ifilot/isa-sdhc-card-interface/bracket/bracket-release-card.stl

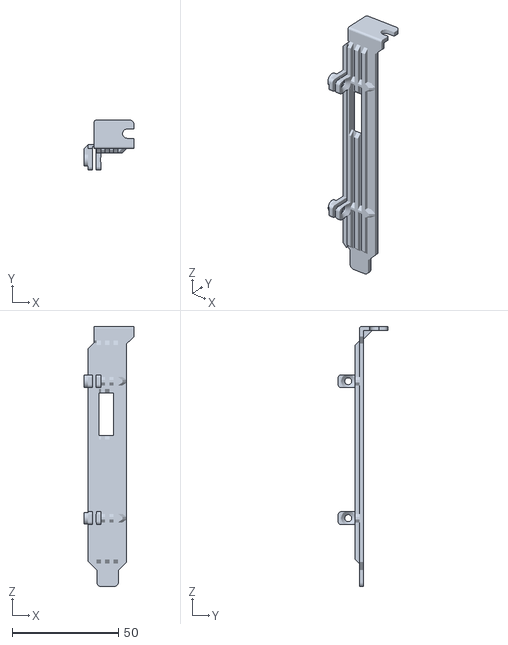
[picture p1: CAD file, 2025-10-16]
bracket/bracket-release-card.stl
23.6 x 23.5 x 122.5
