ifilot/isa-sdhc-card-interface/(list of files, cad)

Other CAD files:
bracket/bracket-prototype-card.stl
