ifilot/isa-sdhc-card-interface/pcb/prototype/prototype.pdf

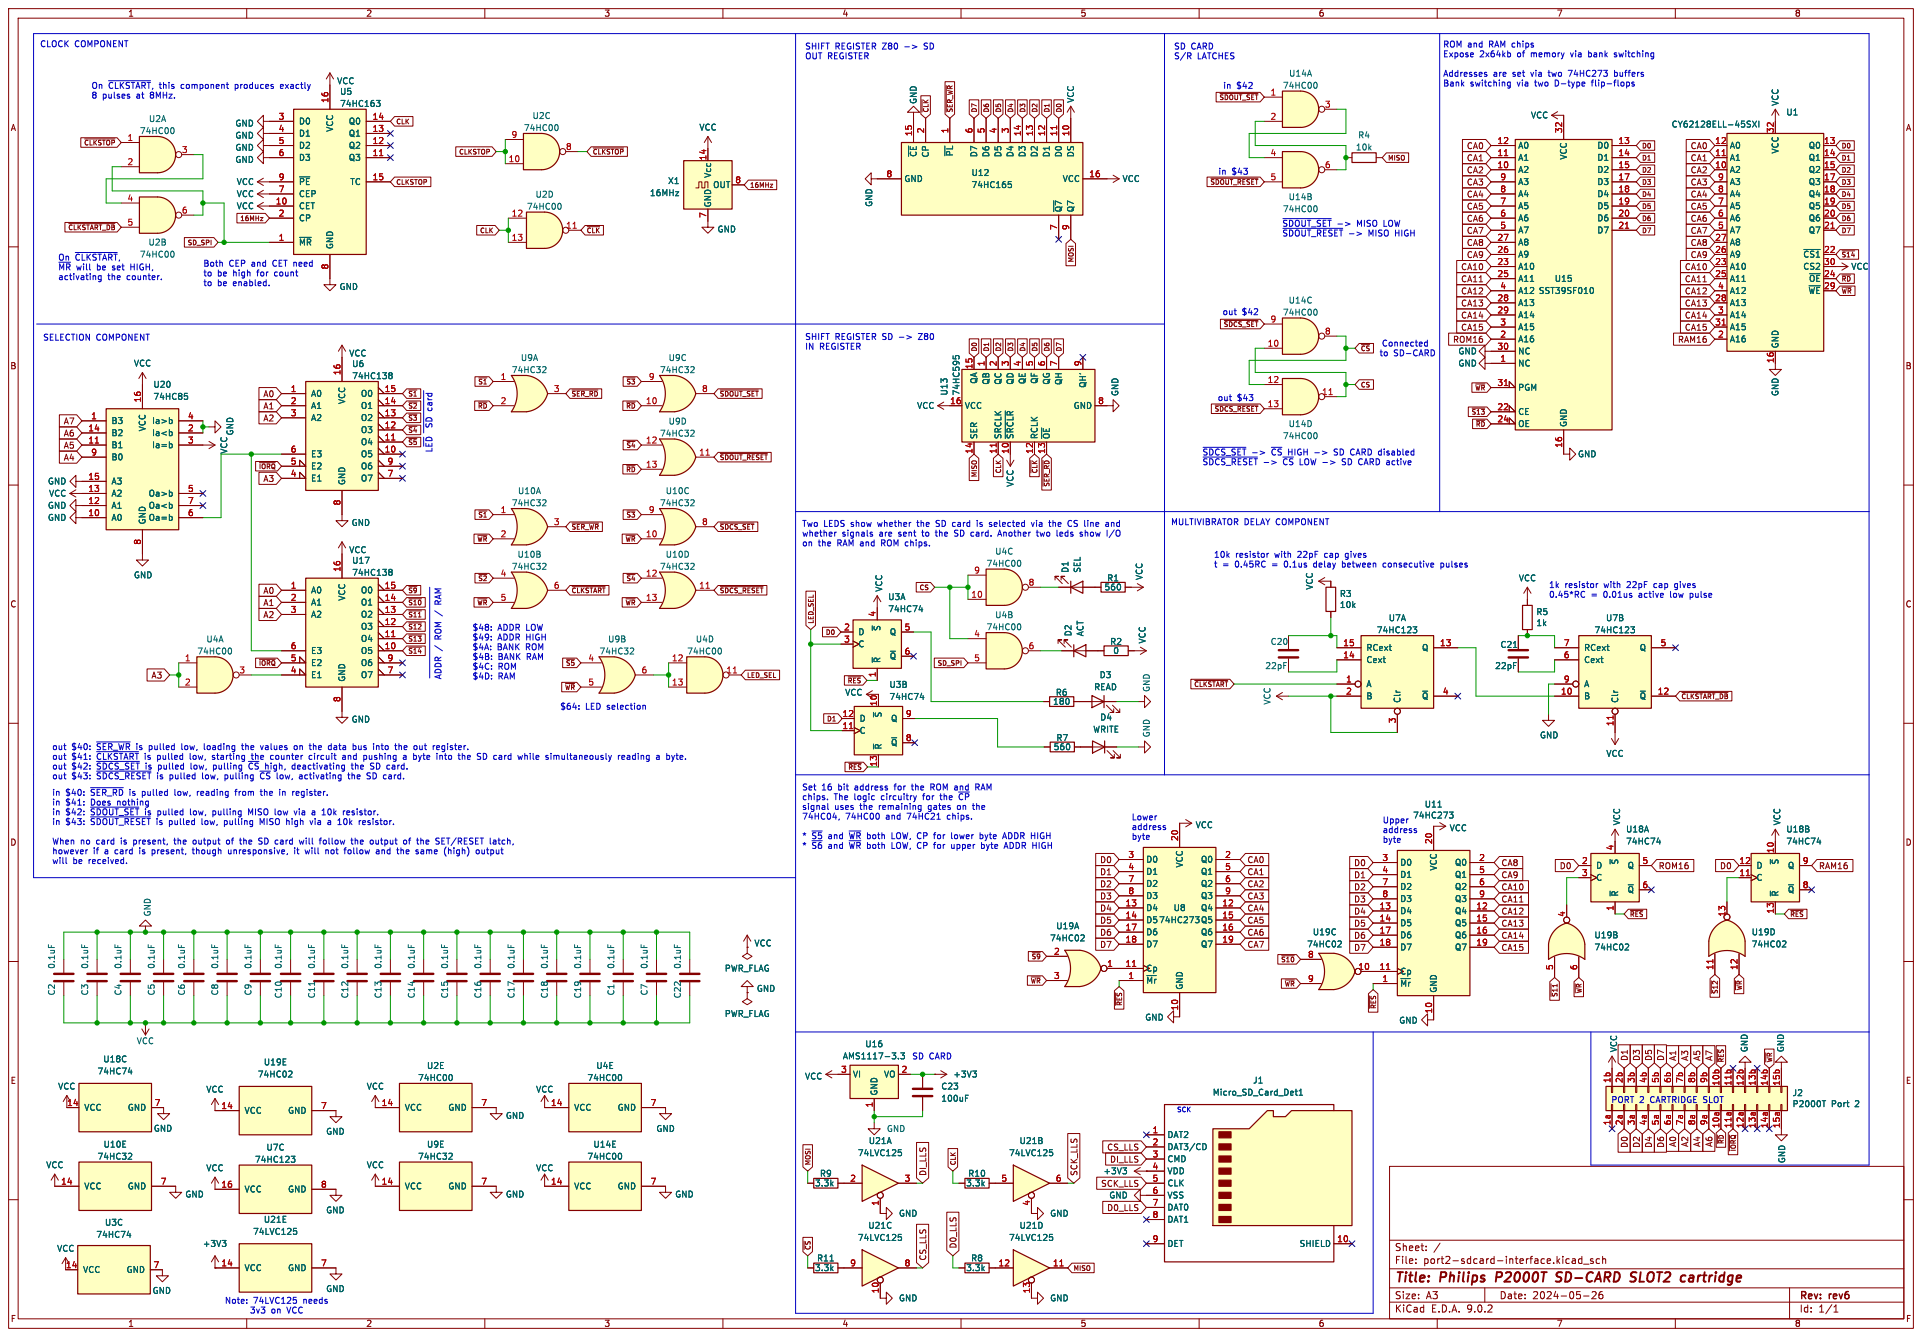
[picture p2: page 1]

8 O0 15 O1 14 O2 13 O3 12 O4 11 O5 10 O6 9 O7 7 VCC VCCGND GND GND GND GND GND

$64: LED selection On ~{CLKSTART},

Both CEP and CET need
to be high for count

MULTIVIBRATOR DELAY COMPONENT Set 16 bit address for the ROM and RAM

on the RAM and ROM chips.

in $40: ~{SER_RD}is pulled low, reading from the in register.
in $41: Does nothing

74HC04, 74HC00 and 74HC21 chips. * ~{S5}and ~{WR}both LOW, CP for lower byte ADDR HIGH

* ~{S6}and ~{WR}both LOW, CP for upper byte ADDR HIGH

Id: 1/1 Title: Philips P2000T SD-CARD SLOT2 cartridge
