ifilot/isa-sdhc-card-interface/(list of files, drawings)

Other design files:
pcb/prototype/prototype.dsn
pcb/release/isa-sdcard.dsn
