ifilot/isa-sdhc-card-interface/pcb/release/isa-sdcard.kicad_pcb

## KiCad design pcb/release/isa-sdcard.kicad_pcb (2025-10-16)

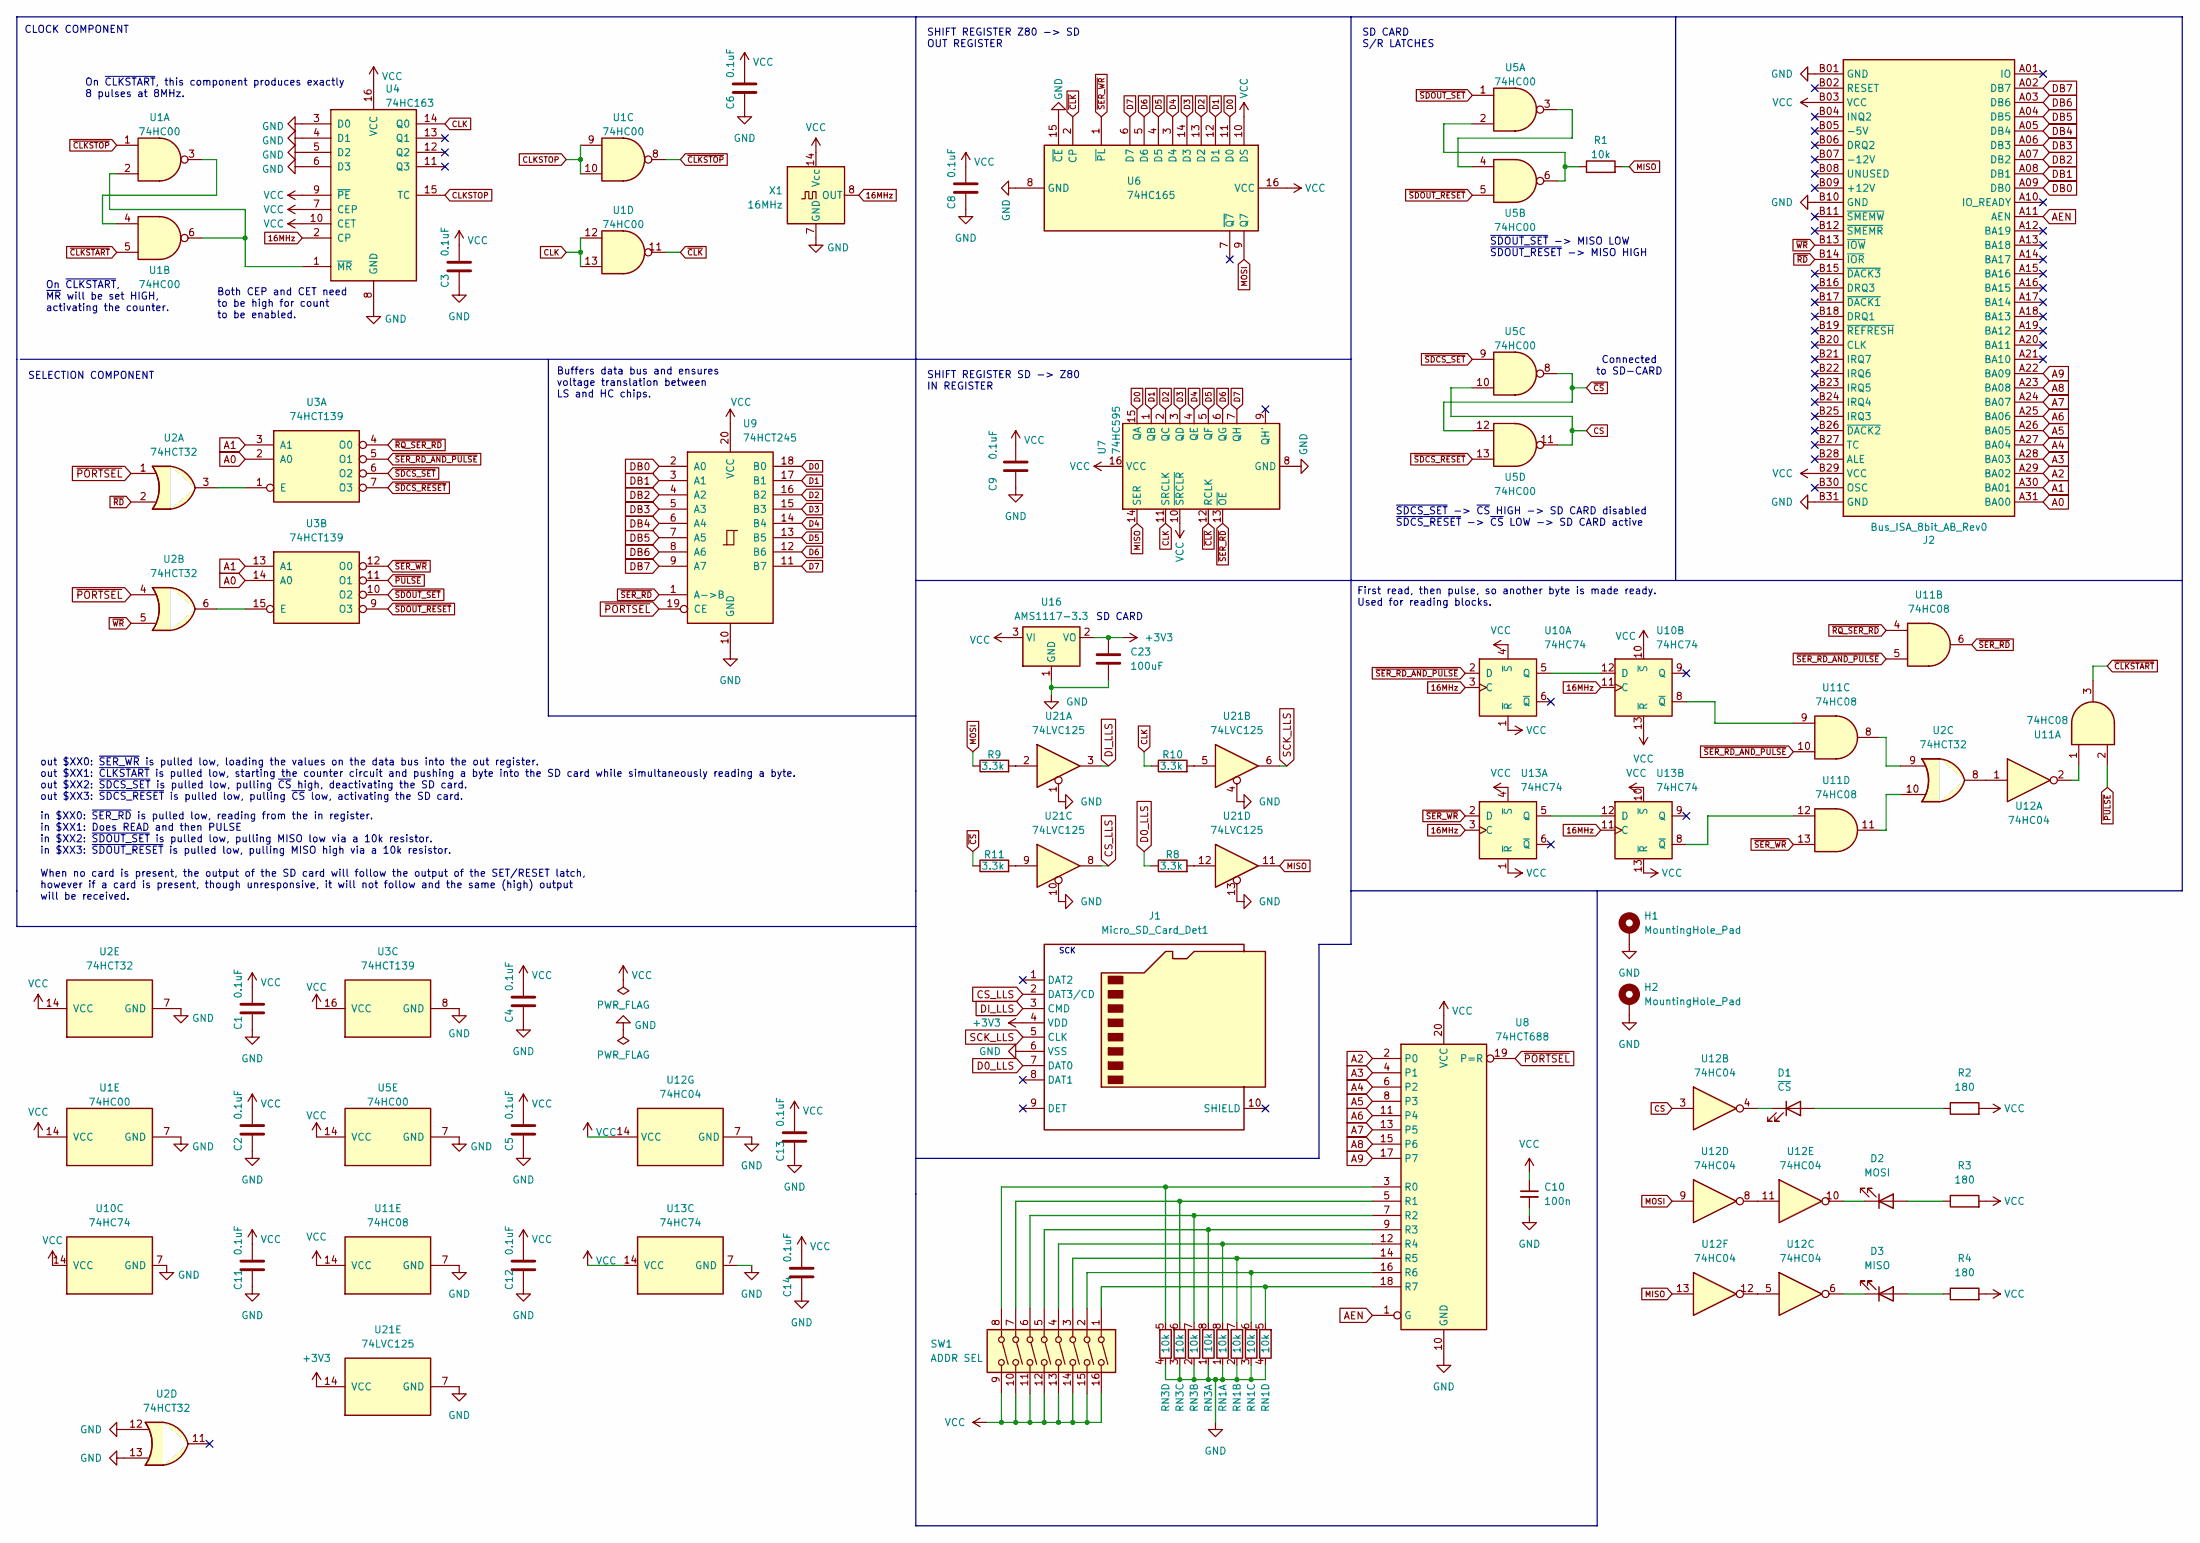
[picture p3: schematic isa-sdcard.kicad_sch, ISA-TO-SDCARD]

Parts:
C1, C2, C3, C4, C5, C6, C8, C9, C11, C12, C13, C14: 0.1uF; C_0805_2012Metric; LCSC Part # C126469
C10: 100n; C_0805_2012Metric
C23: 100uF; C_1206_3216Metric_Pad1.33x1.80mm_HandSolder; LCSC Part # C309030
D1: ~{CS}; LED_0805_2012Metric
D2: MOSI; LED_0805_2012Metric
D3: MISO; LED_0805_2012Metric
H1, H2: MountingHole_Pad; MountingHole_3.2mm_M3_DIN965_Pad_TopBottom
J1: Micro_SD_Card_Det1; CONN9_MSD-1_CUD; LCSC Part # C381082
J2: Bus_ISA_8bit_AB_Rev0; ISA_CARD_EDGE_CONNECTOR_8BIT_Rev1
R1: 10k; R_0805_2012Metric; LCSC Part # C5159708
R2, R3, R4: 180; R_0805_2012Metric
R8, R9, R10, R11: 3.3k; R_0805_2012Metric_Pad1.20x1.40mm_HandSolder; LCSC Part # C407459
RN1, RN3: 10k; R_Array_Convex_4x0612
SW1: ADDR SEL; SW_DIP_SPSTx08_Slide_9.78x22.5mm_W7.62mm_P2.54mm
U1, U5: 74HC00; SOIC-14_3.9x8.7mm_P1.27mm; LCSC Part # C699445
U2: 74HCT32; SOIC-14_3.9x8.7mm_P1.27mm
U3: 74HCT139; SOIC-16_3.9x9.9mm_P1.27mm
U4: 74HC163; SOIC-16_3.9x9.9mm_P1.27mm; LCSC Part # C338758
U6: 74HC165; SOIC-16_3.9x9.9mm_P1.27mm; LCSC Part # C5613
U7: 74HC595; SOIC-16_3.9x9.9mm_P1.27mm; LCSC Part # C5947
U8: 74HCT688; SOIC-20W_7.5x12.8mm_P1.27mm
U9: 74HCT245; SOIC-20W_7.5x12.8mm_P1.27mm
U10, U13: 74HC74; SOIC-14_3.9x8.7mm_P1.27mm
U11: 74HC08; SOIC-14_3.9x8.7mm_P1.27mm
U12: 74HC04; SOIC-14_3.9x8.7mm_P1.27mm
U16: AMS1117-3.3; SOT-223-3_TabPin2; LCSC Part # C5346136
U21: 74LVC125; TSSOP-14_4.4x5mm_P0.65mm
X1: 16MHz; Oscillator_DIP-14

Connections:
16MHz: U4.2 (CP), U10.3 (C), U10.11 (C), U13.3 (C), U13.11 (C), X1.8 (OUT)
+3V3: C23.1, J1.4 (VDD), U16.2 (VO), U21.14 (VCC)
A0: J2.A31 (BA00), U3.2 (A0), U3.14 (A0)
A1: J2.A30 (BA01), U3.3 (A1), U3.13 (A1)
A2: J2.A29 (BA02), U8.2 (P0)
A3: J2.A28 (BA03), U8.4 (P1)
A4: J2.A27 (BA04), U8.6 (P2)
A5: J2.A26 (BA05), U8.8 (P3)
A6: J2.A25 (BA06), U8.11 (P4)
A7: J2.A24 (BA07), U8.13 (P5)
A8: J2.A23 (BA08), U8.15 (P6)
A9: J2.A22 (BA09), U8.17 (P7)
AEN: J2.A11 (AEN), U8.1 (G)
CLK: R10.1, U1.12, U1.13, U4.14 (Q0), U7.11 (SRCLK)
CLKSTOP: U1.9, U1.10, U4.15 (TC)
CS: U5.10, U5.11, U12.3
CS_LLS: J1.2 (DAT3/CD), U21.8
D0: U6.11 (D0), U7.15 (QA), U9.18 (B0)
D0_LLS: J1.7 (DAT0), R8.1
D1: U6.12 (D1), U7.1 (QB), U9.17 (B1)
D2: U6.13 (D2), U7.2 (QC), U9.16 (B2)
D3: U6.14 (D3), U7.3 (QD), U9.15 (B3)
D4: U6.3 (D4), U7.4 (QE), U9.14 (B4)
D5: U6.4 (D5), U7.5 (QF), U9.13 (B5)
D6: U6.5 (D6), U7.6 (QG), U9.12 (B6)
D7: U6.6 (D7), U7.7 (QH), U9.11 (B7)
DB0: J2.A09 (DB0), U9.2 (A0)
DB1: J2.A08 (DB1), U9.3 (A1)
DB2: J2.A07 (DB2), U9.4 (A2)
DB3: J2.A06 (DB3), U9.5 (A3)
DB4: J2.A05 (DB4), U9.6 (A4)
DB5: J2.A04 (DB5), U9.7 (A5)
DB6: J2.A03 (DB6), U9.8 (A6)
DB7: J2.A02 (DB7), U9.9 (A7)
DI_LLS: J1.3 (CMD), U21.3
GND: C1.1, C2.1, C3.1, C4.1, C5.1, C6.1, C8.1, C9.1, C10.2, C11.1, C12.1, C13.1, C14.1, C23.2, H1.1, H2.1, J1.6 (VSS), J2.B01 (GND), J2.B10 (GND), J2.B31 (GND), RN1.1 (R1.1), RN1.2 (R2.1), RN1.3 (R3.1), RN1.4 (R4.1), RN3.1 (R1.1), RN3.2 (R2.1), RN3.3 (R3.1), RN3.4 (R4.1), U1.7 (GND), U2.7 (GND), U2.12, U2.13, U3.8 (GND), U4.3 (D0), U4.4 (D1), U4.5 (D2), U4.6 (D3), U4.8 (GND), U5.7 (GND), U6.8 (GND), U6.15 (~CE), U7.8 (GND), U8.10 (GND), U9.10 (GND), U10.7 (GND), U11.7 (GND), U12.7 (GND), U13.7 (GND), U16.1 (GND), U21.1, U21.4, U21.7 (GND), U21.10, U21.13, X1.7 (GND)
MISO: R1.2, U7.14 (SER), U12.13, U21.11
MOSI: R9.1, U6.9 (Q7), U12.9
unnamed: D1.2 (A), R2.1
unnamed: D1.1 (K), U12.4
unnamed: D2.2 (A), R3.1
unnamed: D2.1 (K), U12.10
unnamed: D3.2 (A), R4.1
unnamed: D3.1 (K), U12.6
unnamed: R1.1, U5.2, U5.6
unnamed: R8.2, U21.12
unnamed: R9.2, U21.2
unnamed: R10.2, U21.5
unnamed: R11.2, U21.9
unnamed: RN1.8 (R1.2), SW1.4, U8.12 (R4)
unnamed: RN1.7 (R2.2), SW1.3, U8.14 (R5)
unnamed: RN1.6 (R3.2), SW1.2, U8.16 (R6)
unnamed: RN1.5 (R4.2), SW1.1, U8.18 (R7)
unnamed: RN3.8 (R1.2), SW1.5, U8.9 (R3)
unnamed: RN3.7 (R2.2), SW1.6, U8.7 (R2)
unnamed: RN3.6 (R3.2), SW1.7, U8.5 (R1)
unnamed: RN3.5 (R4.2), SW1.8, U8.3 (R0)
unnamed: U1.3, U1.4
unnamed: U2.3, U3.1 (E)
unnamed: U2.6, U3.15 (E)
unnamed: U1.2, U1.6, U4.1 (~MR)
unnamed: U5.3, U5.4
unnamed: U10.5 (Q), U10.12 (D)
unnamed: U10.8 (~Q), U11.9
unnamed: U11.1, U12.2
unnamed: U2.9, U11.8
unnamed: U2.10, U11.11
unnamed: U2.8, U12.1
unnamed: U12.8, U12.11
unnamed: U12.5, U12.12
unnamed: U13.5 (Q), U13.12 (D)
unnamed: U11.12, U13.8 (~Q)
SCK_LLS: J1.5 (CLK), U21.6
VCC: C1.2, C2.2, C3.2, C4.2, C5.2, C6.2, C8.2, C9.2, C10.1, C11.2, C12.2, C13.2, C14.2, J2.B03 (VCC), J2.B29 (VCC), R2.2, R3.2, R4.2, SW1.9, SW1.10, SW1.11, SW1.12, SW1.13, SW1.14, SW1.15, SW1.16, U1.14 (VCC), U2.14 (VCC), U3.16 (VCC), U4.7 (CEP), U4.9 (~PE), U4.10 (CET), U4.16 (VCC), U5.14 (VCC), U6.10 (DS), U6.16 (VCC), U7.10 (~SRCLR), U7.16 (VCC), U8.20 (VCC), U9.20 (VCC), U10.1 (~R), U10.4 (~S), U10.10 (~S), U10.13 (~R), U10.14 (VCC), U11.14 (VCC), U12.14 (VCC), U13.1 (~R), U13.4 (~S), U13.10 (~S), U13.13 (~R), U13.14 (VCC), U16.3 (VI), X1.14 (Vcc)
~CLKSTART: U1.5, U11.3
~CLKSTOP: U1.1, U1.8
~CLK: U1.11, U6.2 (CP), U7.12 (RCLK)
~CS: R11.1, U5.8, U5.12
~PORTSEL: U2.1, U2.4, U8.19 (P=R), U9.19 (CE)
~PULSE: U3.11 (O1), U11.2
~RD: J2.B14 (~IOR), U2.2
~RQ_SER_RD: U3.4 (O0), U11.4
~SDCS_RESET: U3.7 (O3), U5.13
~SDCS_SET: U3.6 (O2), U5.9
~SDOUT_RESET: U3.9 (O3), U5.5
~SDOUT_SET: U3.10 (O2), U5.1
~SER_RD_AND_PULSE: U3.5 (O1), U10.2 (D), U11.5, U11.10
~SER_RD: U7.13 (~OE), U9.1 (A->B), U11.6
~SER_WR: U3.12 (O0), U6.1 (~PL), U11.13, U13.2 (D)
~WR: J2.B13 (~IOW), U2.5

Notes on the sheet:
First read, then pulse, so another byte is made ready. Used for reading blocks.
SHIFT REGISTER SD -> Z80 IN REGISTER
SD CARD S/R LATCHES
out $XX0: ~{SER_WR} is pulled low, loading the values on the data bus into the out register. out $XX1: ~{CLKSTART} is pulled low, starting the counter circuit and pushing a byte into the SD card while simultaneously reading a byte. out $XX2: ~{SDCS_SET} is pulled low, pulling ~{CS} high, deactivati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
On ~{CLKSTART}, this component produces exactly 8 pulses at 8MHz.
SCK
On ~{CLKSTART}, ~{MR} will be set HIGH, activating the counter.
in $XX0: ~{SER_RD} is pulled low, reading from the in register. in $XX1: Does READ and then PULSE in $XX2: ~{SDOUT_SET} is pulled low, pulling MISO low via a 10k resistor. in $XX3: ~{SDOUT_RESET} is pulled low, pulling MISO high via a 10k resistor. When no card is present, the output of the SD card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
Connected to SD-CARD
~{SDOUT_SET} -> MISO LOW ~{SDOUT_RESET} -> MISO HIGH
~{SDCS_SET} -> ~{CS} HIGH -> SD CARD disabled ~{SDCS_RESET} -> ~{CS} LOW -> SD CARD active
SELECTION COMPONENT
CLOCK COMPONENT
SD CARD
Buffers data bus and ensures voltage translation between LS and HC chips.
Both CEP and CET need to be high for count to be enabled.
SHIFT REGISTER Z80 -> SD OUT REGISTER

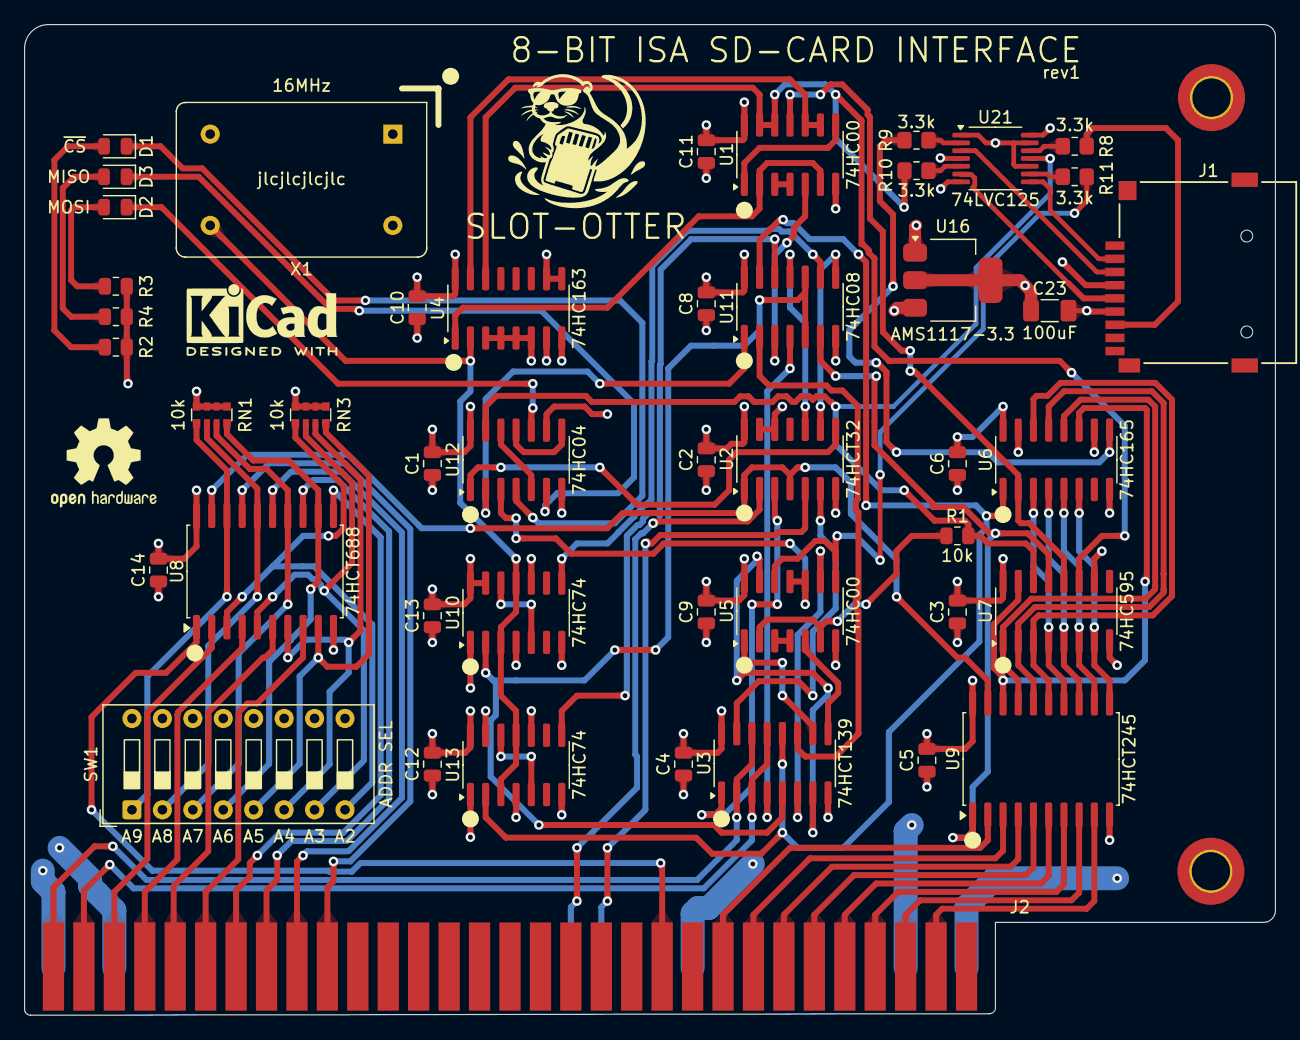
[picture p4: board isa-sdcard.kicad_pcb from above]

Board: 4 copper layers, 104.4 x 82.7 mm, 48 parts (0 on the bottom side), 90 nets.
