ifilot/isa-sdhc-card-interface/src/MAIN.C

#include <stdio.h>
#include <dos.h>

#include "sd.h"
#include "fat32.h"
#include "helpers.h"
#include "view.h"
#include "nav.h"

#define STATE_MAIN_MENU 0
#define STATE_SD        1
#define STATE_NAV       2
#define STATE_EXIT      -1
#define CWDBUFLEN	256

int state_main_menu();
int state_sd();
int state_nav();
void init_fat();
int boot_sd_card();

static char cwd[CWDBUFLEN];

int main() {
    const struct FAT32File* f;
    int c;
    int ret;
    int state = STATE_SD;

    /* try to boot the sd card */
    if(boot_sd_card() != 0) {
	sddis(BASEPORT);
	return -1;
    }

    /* store current working directory */
    getcwd(cwd, CWDBUFLEN);

    /* initialize view */
    view_init();
    disable_cursor();

    /* initialize navigation */
    nav_init();

    /* initialize SD card */
    init_fat();

    while(state != STATE_EXIT) {
	switch(state) {
	    case STATE_MAIN_MENU:
		state = state_main_menu();
	    break;
	    case STATE_SD:
		state = state_sd();
	    break;
	    case STATE_NAV:
		state = state_nav();
	    break;
	    default:
		state = state_main_menu();
	    break;
	}
    }

    /* disable SD card */
    sddis(BASEPORT);

    /* close view */
    view_close();

    /* restore starting cwd */
    chdir(cwd);

    /* restore cursor */
    enable_cursor();

    return 0;
}

int state_main_menu() {
    int c;
    while(1) {
	c = getch();
	if(c == 0) { /* special key */
	    c = getch();
	    switch(c) {
		case 0x44:
		    return STATE_EXIT;
	    }
	}
    }
}

int state_sd() {
    unsigned char c;
    int fpos;
    const struct FAT32File* f;
    char filename[13];

    while(1) {
	c = getch();
	if(c == 0) {
	    c = getch();
	    switch(c) {
		case 0x44:
		    return STATE_EXIT;
		case 0x49:
		    view_move_cursor(-22);
		break;
		case 0x51:
		    view_move_cursor(22);
		break;
	    }
	}
	switch(c) {
	    case 0x09:
		view_remove_cursor();
		nav_set_cursor();
		nav_display_commands();
		return STATE_NAV;
	    case 0x3D:
		fpos = view_get_cursor_pos();
		f = fat32_get_file_entry(fpos);
		if(memcmp(f->basename, ".       ", 8) == 0 ||
		   memcmp(f->basename, "..      ", 8) == 0) {
		    break;
		}
		if(f->attrib & MASK_DIR) {
		    fat32_transfer_folder(f);
		} else {
		    build_dos_filename(f, filename);
		    fat32_transfer_file(f, filename);
		}
		nav_read_files();
		nav_print_files();
		nav_reset_cursor();
		nav_remove_cursor();
	    break;
	    case 0x50:
		view_move_cursor(1);
	    break;
	    case 0x48:
		view_move_cursor(-1);
	    break;
	    case 0x0D:
		fpos = view_get_cursor_pos();
		f = fat32_get_file_entry(fpos);
		if(f->attrib & MASK_DIR) {
		    fat32_set_current_folder(f);
		    view_print_files();
		    view_reset_cursor();
		}
	    break;
	}
    }
}

int state_nav() {
    unsigned char c;
    int fpos;
    const struct NavFile* f;

    while(1) {
	c = getch();
	if(c == 0) {
	    c = getch();
	    switch(c) {
		case 0x3C:
		    nav_create_folder();
		break;
		case 0x44:
		    return STATE_EXIT;
		case 0x49:
		    nav_move_cursor(-22);
		break;
		case 0x51:
		    nav_move_cursor(22);
		break;
	    }
	}
	switch(c) {
	    case 0x09:
		nav_remove_cursor();
		view_set_cursor();
		view_display_commands();
		return STATE_SD;
	    case 0x50:
		nav_move_cursor(1);
	    break;
	    case 0x48:
		nav_move_cursor(-1);
	    break;

	    case 0x0D:
		fpos = nav_get_cursor_pos();
		f = nav_get_file_entry(fpos);
		if(f->attrib & NAV_MASK_DIR) {
		    nav_change_folder(f);
		    nav_read_files();
		    nav_print_files();
		    nav_reset_cursor();
		}
	    break;
	}
    }
}

int boot_sd_card() {
    static unsigned char buf[514];
    int res = -1;
    unsigned attempts = 0;
    while(res != 0 && attempts < 10) {
	attempts++;
	printf("Trying to open SD card (%i)\n", attempts);
	res = sd_boot();
	if(res != 0) {
	    printf("Cannot open SD-card, exiting...\n");
	    continue;
	}
	res = cmd17(BASEPORT, 0x00000000, buf);
	if(res != 0) {
	    printf("Cannot read boot sector.\n");
	    continue;
	}
	if(buf[510] != 0x55 || buf[511] != 0xAA) {
	    printf("Cannot read boot sector pattern.\n");
	    res = -1;
	    continue;
	}
    }
    return res;
}

void init_fat() {
    fat32_open_partition();
    view_print_volume_label(fat32_partition.volume_label);
    fat32_read_current_folder();
    view_print_files();
    view_reset_cursor();
}
