ifilot/isa-sdhc-card-interface/src/FAT32.C

#include "fat32.h"

static unsigned char sdbuf[514];
static unsigned long fat32_linked_list[F32LLSZ];
unsigned int fat32_nrfiles;

struct FAT32Partition fat32_partition;
struct FAT32Folder fat32_root_folder;
struct FAT32Folder fat32_current_folder;
struct FAT32File fat32_files[F32MXFL];
struct FAT32File fat32_folder_contents[F32MXFL];

void fat32_open_partition() {
    unsigned long lba = 0x00000000;
    char partname[12];

    /* read boot sector */
    cmd17(BASEPORT, 0x00000000, sdbuf);
    /*print_block(sdbuf);*/

    /* check for magic bytes */
    if(sdbuf[510] != 0x55 || sdbuf[511] != 0xAA) {
	printf("Could not read SD-card. Try to reinsert.\n");
	sddis(BASEPORT);
	return;
    }

    /* grab start address of first partition */
    lba = *(unsigned long*)(sdbuf + 0x1C6);
    /*printf("LBA: %08X\n", lba);*/

    /* read the partition information */
    fat32_read_sector(lba);

    /* store partition information */
    fat32_partition.bytes_per_sector = *(unsigned*)(sdbuf + 0x0B);
    fat32_partition.sectors_per_cluster = sdbuf[0x0D];
    fat32_partition.reserved_sectors = *(unsigned*)(sdbuf + 0x0E);
    fat32_partition.number_of_fats = sdbuf[0x10];
    fat32_partition.sectors_per_fat = *(unsigned long*)(sdbuf + 0x24);
    fat32_partition.root_dir_first_cluster = *(unsigned long*)(sdbuf + 0x2C);
    fat32_partition.fat_begin_lba = lba + fat32_partition.reserved_sectors;
    fat32_partition.sector_begin_lba = fat32_partition.fat_begin_lba +
	(fat32_partition.number_of_fats * fat32_partition.sectors_per_fat);
    fat32_partition.lba_addr_root_dir = fat32_calculate_sector_address(fat32_partition.root_dir_first_cluster, 0);

    /* grab information from root folder */
    cmd17(BASEPORT, fat32_partition.lba_addr_root_dir, sdbuf);
    memcpy(fat32_partition.volume_label, sdbuf, 11);
    /*printf("Partition name: %11s\n", fat32_partition.volume_label); */

    /* set both current folder and root folder */
    fat32_current_folder.cluster = fat32_partition.root_dir_first_cluster;
    fat32_current_folder.nrfiles = 0;
    memset(fat32_current_folder.name, 0x00, 11);
    fat32_root_folder = fat32_current_folder;
}

void fat32_print_partition_info() {
    printf("Bytes per sector: %i\n", fat32_partition.bytes_per_sector);
    printf("Sectors per cluster: %i\n", fat32_partition.sectors_per_cluster);
    printf("Reserved sectors: %i\n", fat32_partition.reserved_sectors);
    printf("Number of FATs: %i\n", fat32_partition.number_of_fats);
    printf("Root directory first cluster: %08X\n", fat32_partition.root_dir_first_cluster);
    printf("FAT begin LBA: %08X\n", fat32_partition.fat_begin_lba);
    printf("Root directory sector: %08X\n", fat32_partition.lba_addr_root_dir);
}

void fat32_read_dir(struct FAT32Folder* folder, struct FAT32File buffer[]) {
    unsigned char ctr = 0;
    unsigned fctr = 0;
    unsigned i,j;
    unsigned char* locptr = 0;
    struct FAT32File *file = 0;
    unsigned long caddr = 0;

    /* build linked list */
    fat32_build_linked_list(folder->cluster);

    while(fat32_linked_list[ctr] != 0xFFFFFFFF && ctr < F32LLSZ) {
	caddr = fat32_calculate_sector_address(fat32_linked_list[ctr], 0);

	for(i=0; i<fat32_partition.sectors_per_cluster; ++i) {
	    fat32_read_sector(caddr);           /* read sector in memory */
	    locptr = (unsigned char*)(sdbuf);	/* set pointer to sector data */
	    for(j=0; j<16; ++j) { /* consume 16 files entries per sector */
		/* continue if an unused entry is encountered */
		if(*locptr == 0xE5) {
		    locptr += 32;
		    continue;
		}

		/* early exit is a zero is read */
		if(*locptr == 0x00) {
		    folder->nrfiles = fctr;
		    return;
		}

		/* check if we are reading a file or a folder, if so, add it */
		if((*(locptr + 0x0B) & 0x0F) == 0x00) {
		    file = &buffer[fctr];
		    memcpy(file->basename, locptr, 11); /* file name */
		    file->termbyte = 0;	/* by definition */
		    file->attrib = *(locptr + 0x0B);
		    file->cluster = fat32_grab_cluster_address_from_fileblock(locptr);
		    file->filesize = *(unsigned long*)(locptr + 0x1C);
		    fctr++;
		    /* printf("%i: %s %u bytes\n", fctr, file->basename, file->filesize); */

		    /* throw error message if we exceed buffer size */
		    if(fctr > F32MXFL) {
			printf("ERROR: Too many files in folder; cannot parse.");
			return;
		    }
		}
		locptr += 32; /* next file entry */
	    }
	    caddr++; /* next sector */
	}
	ctr++; /* next cluster */
    }
    folder->nrfiles = fctr;
}

void fat32_read_current_folder() {
    fat32_read_dir(&fat32_current_folder, fat32_files);
    fat32_sort_files();
    fat32_nrfiles = fat32_current_folder.nrfiles;
}

void fat32_set_current_folder(const struct FAT32File* entry) {
    if(entry->cluster == 0x00000000) { /* check for ROOT */
	fat32_current_folder = fat32_root_folder;
    } else {
	fat32_current_folder.cluster = entry->cluster;
	fat32_current_folder.nrfiles = 0;
	memcpy(fat32_current_folder.name, entry->basename, 11);
    }
    fat32_read_current_folder();
}

const struct FAT32File* fat32_get_file_entry(unsigned int id) {
    if(id < fat32_current_folder.nrfiles) {
	return &fat32_files[id];
    } else {
	return 0;
    }
}

unsigned long fat32_calculate_sector_address(unsigned long cluster,
					     unsigned char sector) {
    return fat32_partition.sector_begin_lba + (cluster - 2) *
	   fat32_partition.sectors_per_cluster + sector;
}

void fat32_build_linked_list(unsigned long nextcluster) {
    unsigned ctr = 0;
    unsigned item = 0;

    /* clear previous linked list */
    memset(fat32_linked_list, 0xFF, F32LLSZ * sizeof(unsigned long));

    while(nextcluster < 0x0FFFFFF8 && nextcluster != 0 && ctr < F32LLSZ) {
	fat32_linked_list[ctr] = nextcluster;
	fat32_read_sector(fat32_partition.fat_begin_lba + (nextcluster >> 7));
	item = nextcluster & 0x7F;
	nextcluster = *(unsigned long*)(sdbuf + item * 4);
	ctr++;
    }
}

void fat32_sort_files() {
    qsort(fat32_files, fat32_current_folder.nrfiles, sizeof(struct FAT32File), fat32_file_compare);
}

void fat32_list_dir() {
    unsigned int i=0;
    struct FAT32File *file = fat32_files;
    for(i=0; i<fat32_current_folder.nrfiles; ++i) {
	if(file->attrib & MASK_DIR) {
	    printf("%.8s %.3s %08lX DIR\n", file->basename, file->extension, file->cluster);
	} else {
	    printf("%.8s %.3s %08lX %lu\n", file->basename, file->extension, file->cluster, file->filesize);
	}
	file++;
    }
}

int fat32_file_compare(const void* item1, const void* item2) {
    const struct FAT32File *file1 = (const struct FAT32File*)item1;
    const struct FAT32File *file2 = (const struct FAT32File*)item2;

    unsigned char is_dir1 = (file1->attrib & MASK_DIR) != 0;
    unsigned char is_dir2 = (file2->attrib & MASK_DIR) != 0;

    if(is_dir1 && !is_dir2) {
	return -1;
    } else if(!is_dir1 && is_dir2) {
	return 1;
    }

    return strcmp(file1->basename, file2->basename);
}

void fat32_read_sector(unsigned long addr) {
    cmd17(BASEPORT, addr, sdbuf);
}

unsigned long fat32_grab_cluster_address_from_fileblock(unsigned char* loc) {
    return ((unsigned long)*(unsigned*)(loc + 0x14)) << 16 |
			   *(unsigned*)(loc + 0x1A);
}

int fat32_transfer_file(const struct FAT32File *f, const char* path) {
    unsigned long caddr = 0;
    unsigned char ctr = 0;
    unsigned long bcnt = 0;
    int i;
    FILE *outfile;

    if(f->filesize > (512UL * (unsigned long)fat32_partition.sectors_per_cluster * F32LLSZ)) {
	printf("File too large to be copied!\n");
	return -1;
    }

    if(f->attrib & MASK_DIR) {
	return -1;
    }

    outfile = fopen(path, "wb");

    fat32_build_linked_list(f->cluster);
    while(fat32_linked_list[ctr] != 0xFFFFFFFF && ctr < F32LLSZ && bcnt < f->filesize) {
	caddr = fat32_calculate_sector_address(fat32_linked_list[ctr], 0);

	for(i=0; i<fat32_partition.sectors_per_cluster; ++i) {
	    fat32_read_sector(caddr);

	    if((f->filesize - bcnt) > 512) {
		fwrite(sdbuf, sizeof(char), 512, outfile);
	    } else {
		fwrite(sdbuf, sizeof(char), f->filesize - bcnt, outfile);
		break;
	    }

	    bcnt += 512;
	    caddr++; /* next sector */
	}

	ctr++;
    }

    fclose(outfile);

    return 0;
}

void fat32_transfer_folder(const struct FAT32File* f) {
    static struct FAT32Folder folders[F32MXDIR];
    unsigned nrfolders = 1;
    unsigned newfolders = 1;
    unsigned startfolder = 0;
    unsigned i,j,k;
    const struct FAT32File* fptr;
    char path[MAXPATH];
    int ret;

    /* initialize iterative procedure */
    memcpy(folders[0].name, f->basename, 11);
    folders[0].cluster = f->cluster;
    folders[0].nrfiles = 0;
    folders[0].attrib = 0x00;
    folders[0].reference = -1;

    /* recursively go over the folders until no unscanned folders are found */
    while(newfolders != 0) {
	startfolder = nrfolders - newfolders;
	newfolders = 0;
	for(i=startfolder; i<nrfolders; ++i) {
	    /* read folder contents */
	    fat32_read_dir(&folders[i], fat32_folder_contents);

	    /* loop over files and look for subfolders */
	    for(j=0; j<folders[i].nrfiles; ++j) {
		fptr = &fat32_folder_contents[j];

		/* skip self and parent folder */
		if(memcmp(fptr->basename, ".       ", 8) == 0 ||
		    memcmp(fptr->basename, "..      ", 8) == 0) {
		    continue;
		}

		/* if entry is a folder, add it to the list */
		if(fat32_folder_contents[j].attrib & MASK_DIR) {
		    memcpy(folders[nrfolders].name, fptr->basename, 11);
		    folders[nrfolders].cluster = fptr->cluster;
		    folders[nrfolders].attrib = 0x00;
		    folders[nrfolders].nrfiles = 0;
		    folders[nrfolders].reference = i;
		    newfolders++;
		    nrfolders++;
		}
	    }
	    /* tag folder as being scanned */
	    folders[i].attrib = 0x01;
	}
    }

    store_screen();
    clrscr();
    gotoxy(1,1);
    printf("START TRANSFER...\n");
    for(i=0; i<nrfolders; ++i) {
	fat32_build_path(folders, i, path);
	printf(">> DIR: %s", path);

	if(folder_exists(path)) {
	    printf(" [EXISTS]\n");
	} else {
	    ret = mkdir(path);

	    if(ret == 0) {
		printf(" [CREATED]\n");
	    } else {
		printf(" [ERROR]\n");
		return;
	    }
	}

	/* if no errors were encountered creating the folder, start
	   transferring all the files */
	fat32_transfer_files_in_folder(&folders[i], path);
    }
    printf("-- Transfer complete, press any key to return to navigator. --");
    getch();
    restore_screen();
}

void fat32_build_path(struct FAT32Folder folders[], unsigned id, char path[]) {
    unsigned ll[20];
    unsigned i,N;
    unsigned n;
    const char* name;
    const char* p;

    /* construct linked list */
    ll[0] = id;
    i = 0;

    /* populate linked list */
    while(folders[ll[i]].reference != -1 && i<20) {
	i++;
	ll[i] = (unsigned)folders[ll[i-1]].reference;
    }
    N = i+1; /* number of path sections */

    /* build path */
    memset(path, 0x00, MAXPATH);
    n = 0;
    for(i=0; i<N; ++i) {
	name = folders[ll[N-i-1]].name;
	p = (const char*)strchr(name, (int)' ');
	memcpy(&path[n], name, (size_t)(p - name));
	n += (unsigned)(p - name);
	path[n++] = '\\';
    }
    path[--n] = 0; /* remove trailing slash */
}

void fat32_transfer_files_in_folder(struct FAT32Folder* f, const char *basepath) {
    unsigned i;
    const struct FAT32File* entry;
    char path[MAXPATH];
    char filename[13];
    char c;
    unsigned ok = 0;
    unsigned persistent = 0;
    clock_t tic, toc;

    /* read folder */
    fat32_read_dir(f, fat32_folder_contents);

    for(i=0; i<f->nrfiles; ++i) {
	entry = &fat32_folder_contents[i];
	if(entry->attrib & MASK_DIR) {
	    continue;
	} else {
	    ok = 1;
	    strcpy(path, basepath);
	    strcat(path, "\\");
	    build_dos_filename(entry, filename);
	    strcat(path, filename);
	    printf(" + File: %s", path);
	    if(file_exists(path)) {
		ok = 0;
		if(!persistent) {
		    printf("\n File exists; Overwrite? (y/n/a)");
		    while(1) {
			c = getch();
			if(c == 'y') {
			    putch(c);
			    ok = 1;
			    break;
			} else if(c == 'n') {
			    putch(c);
			    printf(" [SKIP]\n");
			    break;
			} else if(c == 'a') {
			    putch(c);
			    persistent = 1;
			    ok = 1;
			    break;
			}
		    }
		} else {
		    printf(" (A) ");
		    ok = 1; /* ok is always true when persistent is 1 */
		}
	    }
	    if(ok == 1) {
		tic = clock();
		if(fat32_transfer_file(entry, path) == 0) {
		    toc = clock();
		    printf(" (%lu bytes; %.2f s) [OK]\n", entry->filesize,
		      (toc - tic) / CLK_TCK);
		} else {
		    printf(" [FAIL]\n");
		}
	    }
	}
    }
}
