ifilot/isa-sdhc-card-interface/(commit log)

2025-08-17 Revising schematics and layout
    [isa-sdcard.kicad_pcb, isa-sdcard.kicad_sch]
2025-08-20 Revising design
    [isa-sdcard.dsn, isa-sdcard.kicad_pcb, isa-sdcard.kicad_sch]
2025-08-24 Revising lay-out
    [isa-sdcard.kicad_pcb, isa-sdcard.kicad_sch]
2025-09-07 Revising PCB and adding source code
    [isa-sdcard.kicad_pcb]
2025-09-07 Leveraging some routines to assembly
2025-09-07 Adding helper and polishing assembly routines for SD interfacing
2025-09-12 Expanding PCB and adding reading directory to firmware
    [isa-sdcard.kicad_pcb, isa-sdcard.kicad_sch]
2025-09-14 Adding immediate pulse after rwrite and optional pulse after read
    [isa-sdcard.kicad_pcb, isa-sdcard.kicad_sch]
2025-09-20 Patching bug for large files and putting version in separate header file
    [FAT32.C, VIEW.C]
2025-09-28 Revising prototype, updating software and adding bracket
    [bracket-prototype-card.stl, isa-sdcard.dsn, isa-sdcard.kicad_pcb, isa-sdcard.kicad_sch, port2-sdcard-interface_bom_bot.csv, prototype.dsn, prototype.kicad_pcb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]
2025-09-28 Fixing software for SDHC cards
    [CRC16.H, FAT32.C, FAT32.H, FATSTRUC.H, HELPERS.H, NAV.H, SD.C, SD.H]
2025-09-28 Adding PCB variant
    [isa-sdcard.kicad_pcb, isa-sdcard.kicad_sch]
2025-10-16 Fixing CS bug in code, adding logos to PCB
    [bracket-release-card.stl, isa-sdcard.kicad_pcb, isa-sdcard.kicad_sch]
